Monash-EPHM-Lab/velocity/README.md

# velocity
Repository for Monash BoSL In water velocity sensor
