Monash-EPHM-Lab/velocity/Charaterisations/Flow Velocity Graph.png

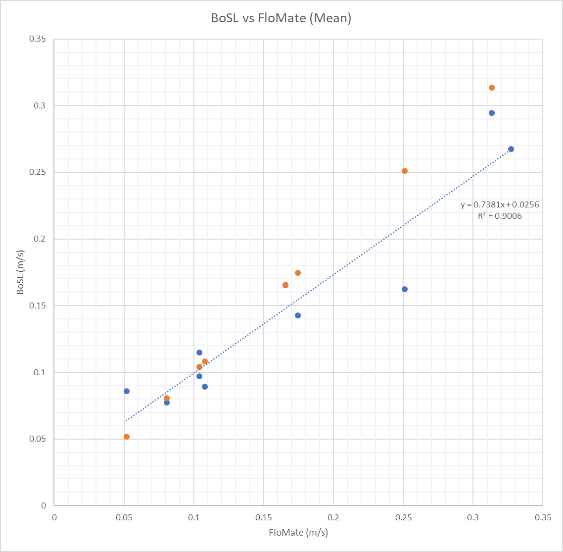
Charaterisations/Flow Velocity Graph.png
