Monash-EPHM-Lab/velocity/LT Simulations/Amp Simulation/Circuit.PNG

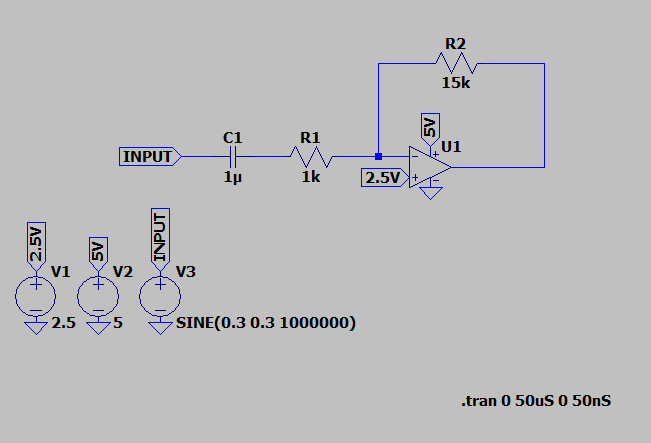
LT Simulations/Amp Simulation/Circuit.PNG
