Monash-EPHM-Lab/velocity/LT Simulations/Amp Simulation/Signals.PNG

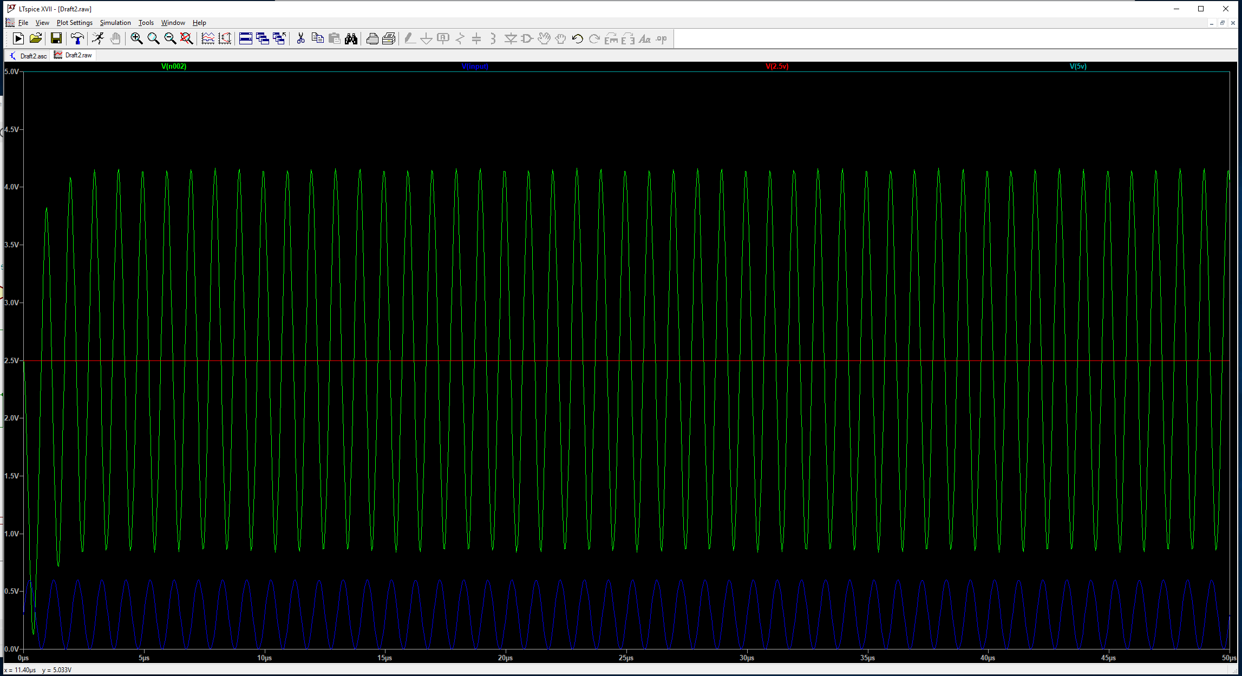
LT Simulations/Amp Simulation/Signals.PNG
