Monash-EPHM-Lab/velocity/EDA/Velocity BOM.xlsx

Part Number | Package Size / Type | Schematic Designator | Component | Value | QTY per board | Unit Price (USD) | Total Price (USD) | Supplier
 |  | LS1, LS2 | 1 MHz Ultrasonic Tranducer |  | 2 | $5.00 | $10.00
 | 0603 | C1 - C5 | SMD Capcitor | 100 nF | 5 | $0.10 | $0.50
 | 0402 | C6 - C10 | SMD Capcitor | 100 nF | 5 | $0.10 | $0.50
 | 0603 | C11 | SMD Capcitor | 22 nF | 1 | $0.10 | $0.10
 | 0603 | C12, C13 | SMD Capcitor | 18 pF | 2 | $0.10 | $0.20
 | 0603 | C14 | SMD Capcitor | 4.7 μF | 1 | $0.10 | $0.10
 | 0603 | C15, C16, C17 | SMD Capcitor | 330 pF | 3 | $0.10 | $0.30
 | 0805 | C18 | SMD Capcitor | 3.3 μF | 1 | $0.10 | $0.10
 | 0603 | C19 - C25 | SMD Capcitor | 1 μF | 8 | $0.10 | $0.80
 | 0805 | C26, C27, C28 | SMD Capcitor | 10 μF | 3 | $0.10 | $0.30
 | 0603 | R1, R3 | SMD Resistor | 20 kΩ | 2 | $0.10 | $0.20
 | 0603 | R2 | SMD Resistor | 3.3 kΩ | 1 | $0.10 | $0.10
 | 0603 | R7, R9 | SMD Resistor | 330 Ω | 2 | $0.10 | $0.20
 | 0603 | R12 | SMD Resistor | 200 Ω | 1 | $0.10 | $0.10
 | 0603 | R13 | SMD Resistor | 100 Ω | 1 | $0.10 | $0.10
 | 0603 | R4, R8, R10, R14, R15 | SMD Resistor | 10 kΩ | 5 | $0.10 | $0.50
 | 0603 | R17 | SMD Resistor | 15 kΩ | 1 | $0.10 | $0.10
 | 0603 | R5, R16 | SMD Resistor | 1 kΩ | 2 | $0.10 | $0.20
 | 0603 | R6 | SMD Resistor | 2.8 MΩ | 1 | $0.10 | $0.10
 | 0603 | R11 | SMD Resistor | 500 kΩ | 1 | $0.10 | $0.10
BLM18PG471SN1D | 0603 | L1 | SMD Inductor |  | 1 | $0.10 | $0.10 | https://au.mouser.com/ProductDetail/Murata-Electronics/BLM18PG471SN1D?qs=EYzdjubb4S%2FN1Ip39GrHyg%3D%3D
XFL4020-472MEC | 4x4mm | L2 | SMD Inductor | 4.7 μH | 1 | $3.00 | $3.00 | https://au.mouser.com/ProductDetail/Coilcraft/XFL4020-472MEC?qs=zCSbvcPd3pYTqnxfKsElWw%3D%3D
SA612AD | SOIC-8 | U1 | RF Mixer |  | 1 | $2.29 | $2.29 | https://www.digikey.com/product-detail/en/nxp-usa-inc/SA612AD-01112/568-1204-5-ND/740395
OPA4354 | SOIC-14 | U2 | 4xOPAmp |  | 1 | $1.80 | $1.80 | https://www.digikey.com/product-detail/en/texas-instruments/OPA4354AIDR/296-12643-2-ND/454201
MAX7375AXR105 | SOT-323/SC-70 | U3 | Oscilator |  | 1 | $1.56 | $1.56 | https://www.digikey.com/product-detail/en/maxim-integrated/MAX7375AXR105-T/MAX7375AXR105-TCT-ND/4490142
ATSAMD21G18A | QFP50-48 | U4 | Microcontroller |  | 1 | $3.00 | $3.00 | https://www.microchip.com/wwwproducts/en/ATsamd21g18
TPS61222 | SC70-6 | U5 | Boost Converter |  | 1 | $1.80 | $1.80 | https://au.mouser.com/ProductDetail/Texas-Instruments/TPS61222DCKR?qs=IDSsxkoac0xpx0kmXXJcTA%3D%3D
AD8226BRZ | SOIC-8 | U6 | Instrumentation Amplifier |  | 1 | $5.00 | $5.00 | https://www.digikey.com/product-detail/en/analog-devices-inc/AD8226BRZ/AD8226BRZ-ND/2182229
SP3075 | SOIC-8 | U7 | RS485 Bus |  | 1 | $2.54 | $2.54 | https://au.element14.com/exar/sp3075een-l/transceiver-rs-485-3v-smd-3075/dp/9386688
FX255 | 4.9mm x 1.8mm | Y1 | Crystal Oscilator | 32.768 kHz | 1 | $1.96 | $1.96 | https://au.rs-online.com/web/p/crystal-units/6480222/
 |  |  |  |  |  |  | $0.00
 |  |  |  |  |  |  | $0.00
 |  |  |  |  |  |  | $0.00
 |  |  |  |  |  |  | $0.00
 |  |  |  |  |  |  | $0.00
 |  |  |  |  |  |  | $0.00
 |  |  |  |  |  |  | $0.00
 |  |  |  |  |  |  | $0.00
 |  |  |  |  |  |  | $0.00
