Monash-EPHM-Lab/velocity/CAD/Small Tranducer/VelocityFRONT.stl

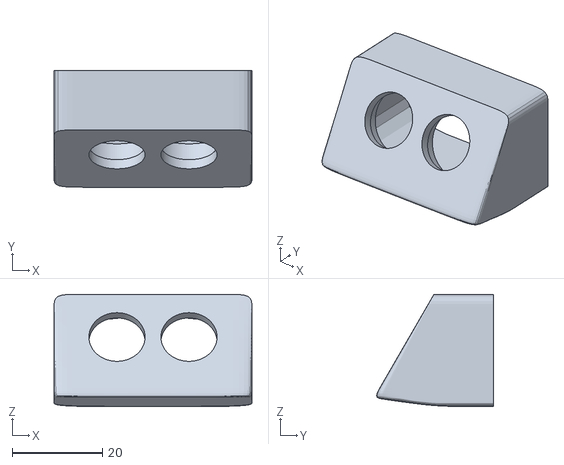
[picture p4: CAD file, 2020-08-11]
CAD/Small Tranducer/VelocityFRONT.stl
44.0 x 25.9 x 25.0
