Monash-EPHM-Lab/velocity/CAD/Velocity_Back.stl

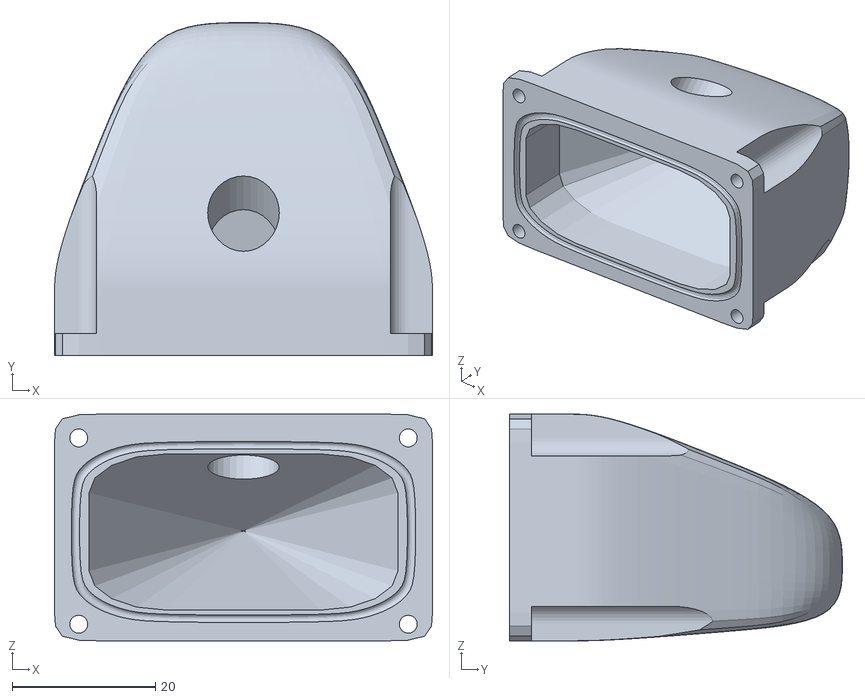
[picture p5: CAD file, 2020-08-11]
CAD/Velocity_Back.stl
52.8 x 46.4 x 31.7
