Monash-EPHM-Lab/velocity/CAD/Small Tranducer/VelocityQUICK.stl

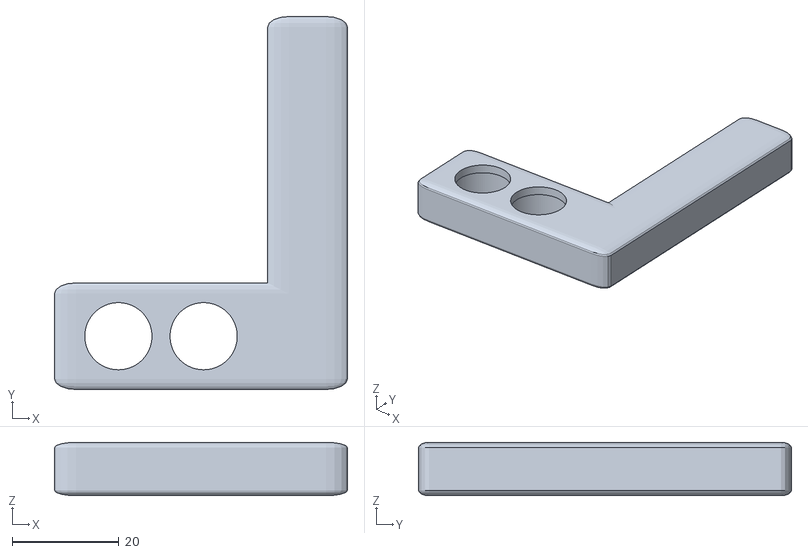
[picture p6: CAD file, 2020-08-11]
CAD/Small Tranducer/VelocityQUICK.stl
55.0 x 70.0 x 10.0
