Monash-EPHM-Lab/velocity/CAD/Velocity_Front.stl

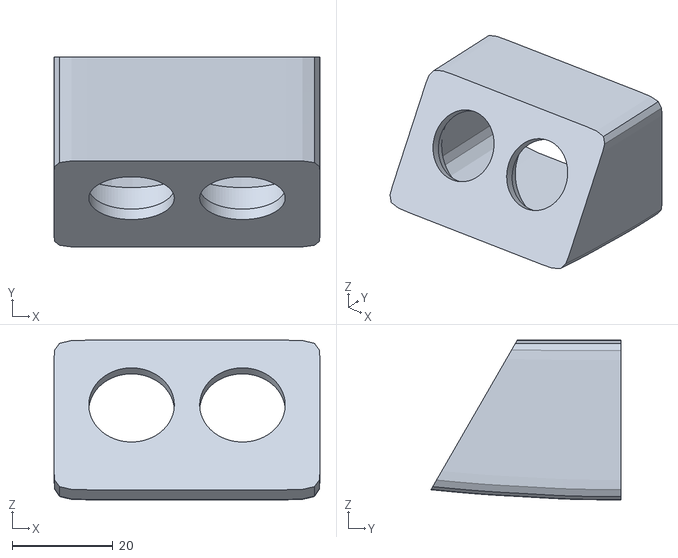
[picture p7: CAD file, 2020-08-11]
CAD/Velocity_Front.stl
52.8 x 37.7 x 31.7
