Monash-EPHM-Lab/velocity/CAD/Small Tranducer/VelocityBACK.stl

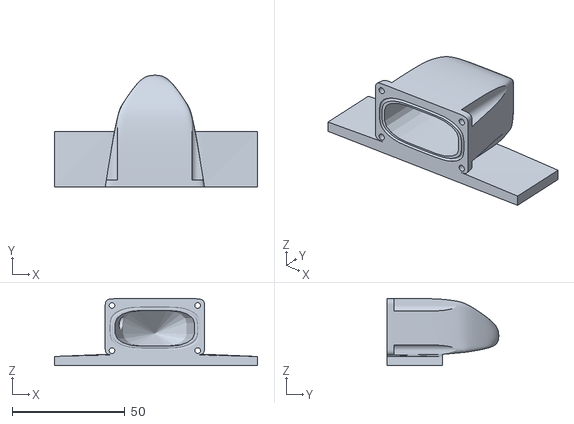
[picture p8: CAD file, 2020-08-11]
CAD/Small Tranducer/VelocityBACK.stl
90.0 x 49.5 x 29.7
