Monash-EPHM-Lab/velocity/(list of files, cad)

Other CAD files:
CAD/Small Tranducer/VelocitySmall.blend
CAD/Velocity.blend
