Monash-EPHM-Lab/velocity/LT Simulations/Heterodyne.asc

C1: cap; 100n
C2: cap; 100n
R1: res; 10k
R2: res; 10k
R3: res; 100
R4: res; 10k
U1: opamp
V1: voltage; SINE(0 AC 1 10000000); AC 1 1000000
V2: voltage; SINE(0 0.1 100)
.lib opamp.sub
.tran 0 30m 0 .1u
