Monash-EPHM-Lab/velocity/LT Simulations/Amp Simulation/TransducerAmp.asc

C1: cap; 1µ
R1: res; 1k
R2: res; 15k
U1: UniversalOpamp2
V1: voltage; 2.5
V2: voltage; 5
V3: voltage; SINE(0.3 0.3 1000000)
V4: voltage; -5
Named nets: 2.5V, 0, 5V, INPUT, -5V
.tran 0 50uS 0 50nS
