Monash-EPHM-Lab/velocity/EDA/Heterodyne/Heterodyne.kicad_pcb

## KiCad design EDA/Heterodyne/Heterodyne.kicad_pcb (2020-08-11)

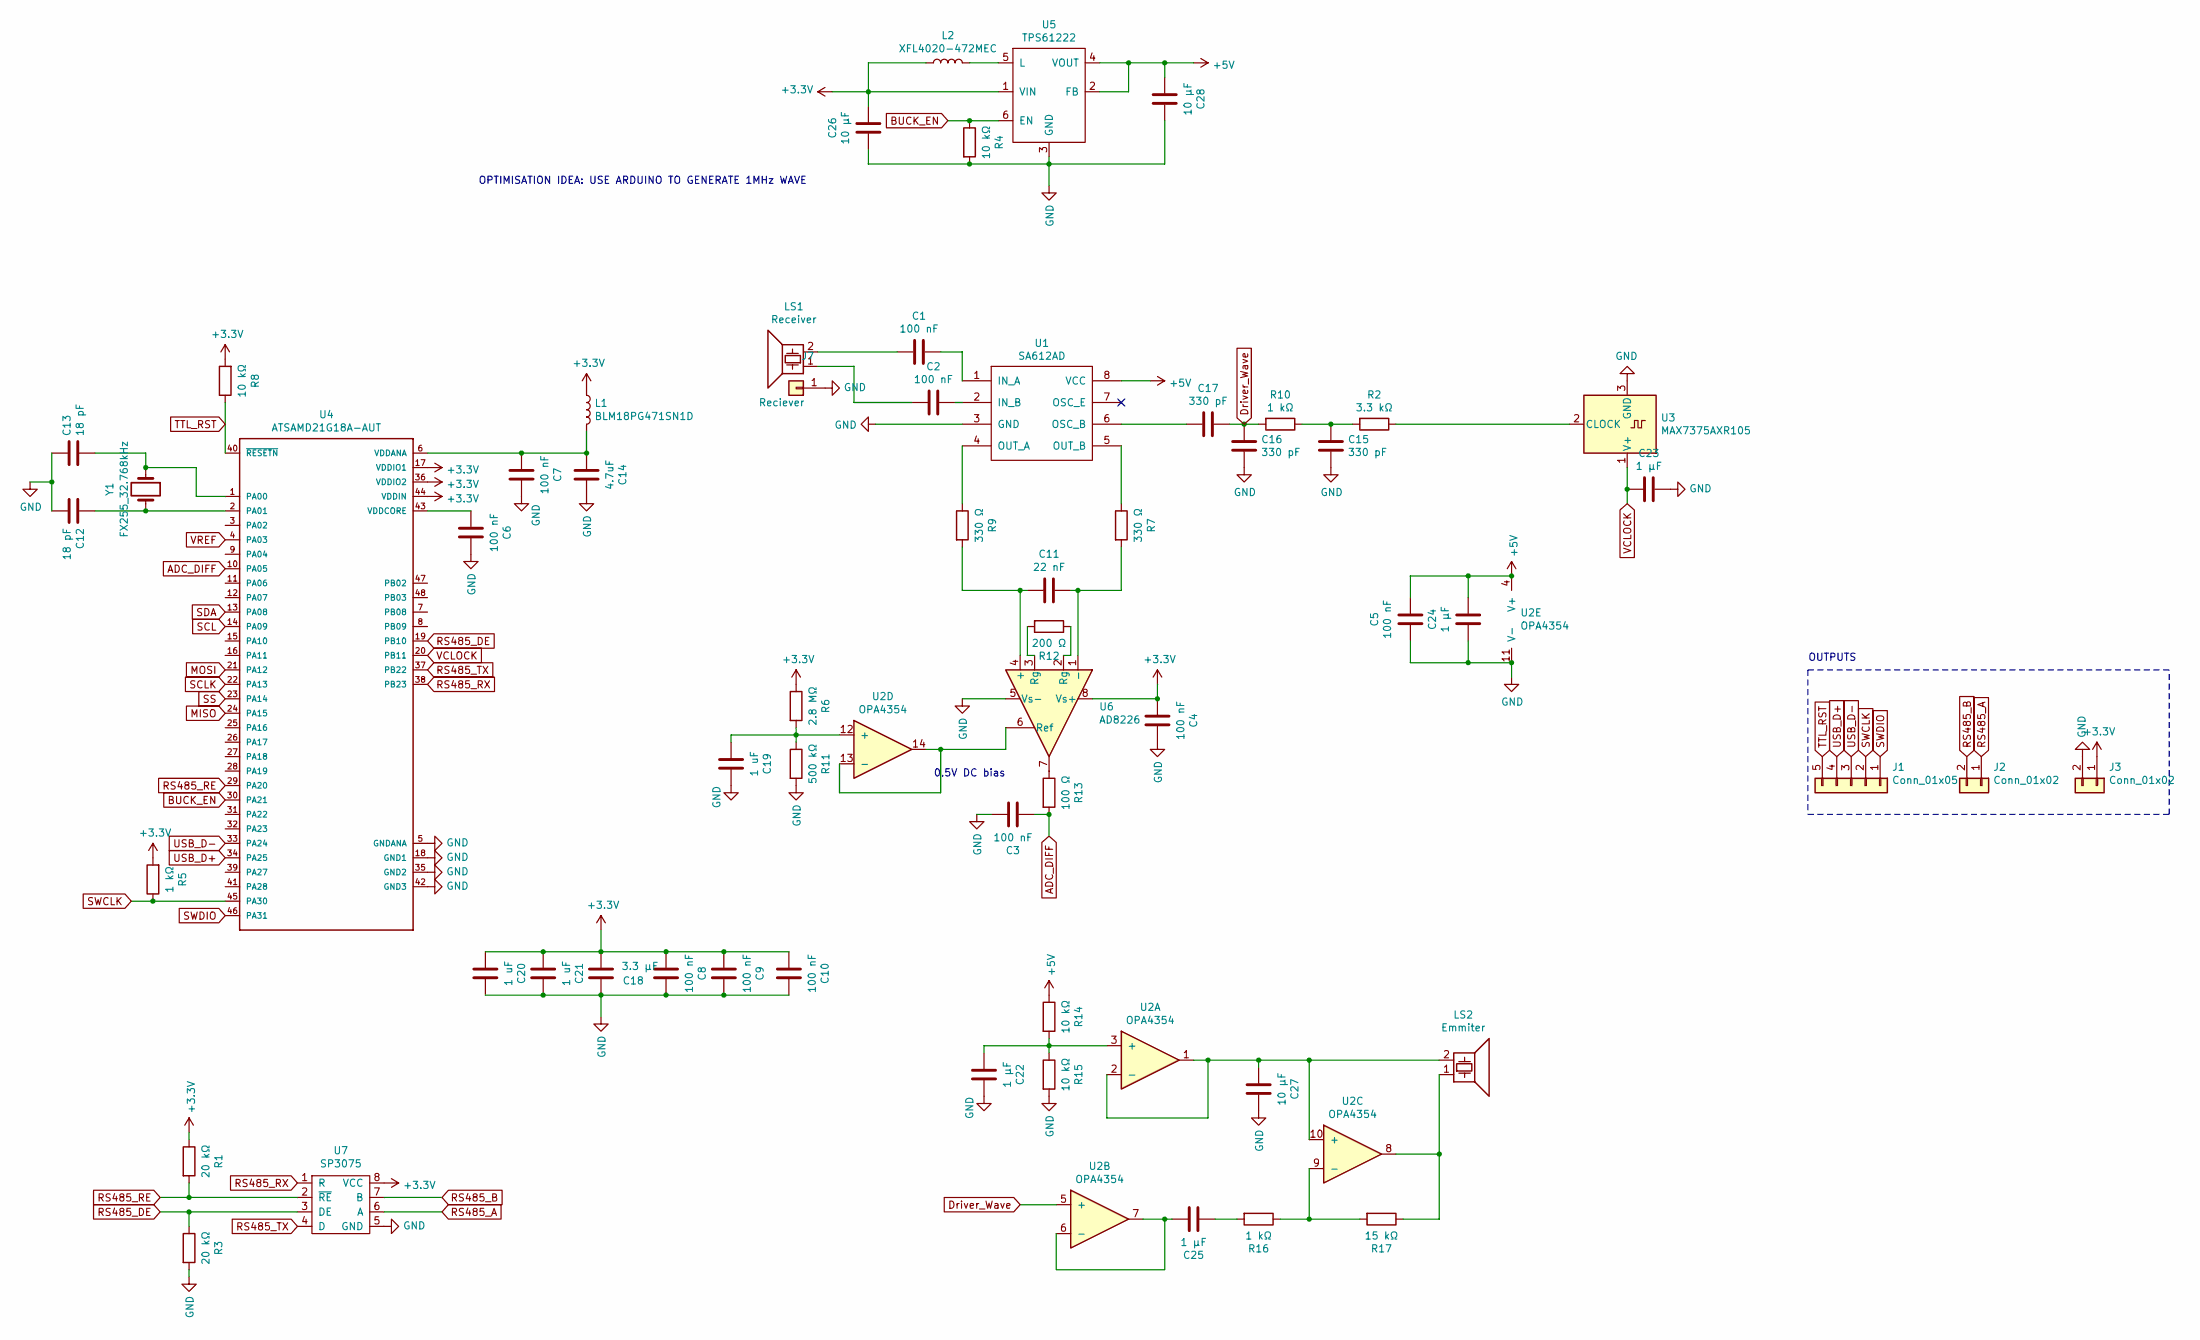
[picture p9: schematic Heterodyne.sch]

Parts:
C1, C2, C3, C4, C5: 100 nF; C_0603_1608Metric_Pad1.05x0.95mm_HandSolder
C6, C7, C8, C9, C10: 100 nF; C_0402_1005Metric
C11: 22 nF; C_0603_1608Metric_Pad1.05x0.95mm_HandSolder
C12, C13: 18 pF; C_0603_1608Metric_Pad1.05x0.95mm_HandSolder
C14: 4.7uF; C_0603_1608Metric
C15, C16, C17: 330 pF; C_0603_1608Metric_Pad1.05x0.95mm_HandSolder
C18: 3.3 μF; C_0805_2012Metric
C19, C20, C21: 1 uF; C_0603_1608Metric_Pad1.05x0.95mm_HandSolder
C22: 1 μF; C_0603_1608Metric_Pad1.05x0.95mm_HandSolder
C23, C24, C25: 1 μF; C_0603_1608Metric
C26, C27, C28: 10 μF; C_0805_2012Metric
J1: Conn_01x05; PinHeader_1x05_P2.54mm_Vertical
J2, J3: Conn_01x02; PinHeader_1x02_P2.54mm_Vertical
J7: Reciever; PinSocket_1x01_P2.54mm_Vertical
L1: BLM18PG471SN1D; C_0603_1608Metric
L2: XFL4020-472MEC; L_Coilcraft_XxL4020
LS1: Receiver; PinHeader_1x02_P2.54mm_Vertical
LS2: Emmiter; PinHeader_1x02_P2.54mm_Vertical
R1, R3: 20 kΩ; R_0603_1608Metric_Pad1.05x0.95mm_HandSolder
R2: 3.3 kΩ; R_0603_1608Metric_Pad1.05x0.95mm_HandSolder
R4, R8, R14, R15: 10 kΩ; R_0603_1608Metric_Pad1.05x0.95mm_HandSolder
R5: 1 kΩ; R_0603_1608Metric
R6: 2.8 MΩ; R_0603_1608Metric_Pad1.05x0.95mm_HandSolder
R7, R9: 330 Ω; R_0603_1608Metric_Pad1.05x0.95mm_HandSolder
R10, R16: 1 kΩ; R_0603_1608Metric_Pad1.05x0.95mm_HandSolder
R11: 500 kΩ; R_0603_1608Metric_Pad1.05x0.95mm_HandSolder
R12: 200 Ω; R_0603_1608Metric_Pad1.05x0.95mm_HandSolder
R13: 100 Ω; R_0603_1608Metric_Pad1.05x0.95mm_HandSolder
R17: 15 kΩ; R_0603_1608Metric_Pad1.05x0.95mm_HandSolder
U1: SA612AD; SOIC-8_5.275x5.275mm_P1.27mm
U2: OPA4354
U3: MAX7375AXR105; SOT-323_SC-70_Handsoldering
U4: ATSAMD21G18A-AUT; QFP50P900X900X120-48N
U5: TPS61222; SOT-363_SC-70-6
U6: AD8226; SOIC-8_3.9x4.9mm_P1.27mm
U7: SP3075; SOIC-8_3.9x4.9mm_P1.27mm
Y1: FX255_32.768kHz; Crystal_SMD_MicroCrystal_CC4V-T1A-2Pin_5.0x1.9mm

Connections:
+3V3: C4.2, C8.2, C9.2, C10.2, C18.2, C20.2, C21.2, C26.1, J3.1, L1.1, L2.1, R1.1, R5.2, R6.1, R8.2, U4.17 (VDDIO1), U4.36 (VDDIO2), U4.44 (VDDIN), U5.1 (VIN), U6.8 (Vs+), U7.8 (VCC)
+5V: C5.1, C24.1, C28.2, R14.1, U1.8 (VCC), U2.4 (V+), U5.2 (FB), U5.4 (VOUT); also elsewhere on the board
ADC_DIFF: C3.2, R13.2, U4.10 (PA05)
BUCK_EN: R4.1, U4.30 (PA21), U5.6 (EN)
Driver_Wave: C16.2, C17.1, R10.2, U2.5 (+)
GND: C3.1, C4.1, C5.2, C6.1, C7.1, C8.1, C9.1, C10.1, C12.2, C13.1, C14.1, C15.2, C16.1, C18.1, C19.1, C20.1, C21.1, C22.1, C23.1, C24.2, C26.2, C27.1, C28.1, J3.2, J7.1, R3.2, R4.2, R11.2, R15.2, U1.3 (GND), U2.11 (V-), U3.3 (GND), U4.5 (GNDANA), U4.18 (GND1), U4.35 (GND2), U4.42 (GND3), U5.3 (GND), U6.5 (Vs-), U7.5 (GND); also elsewhere on the board
MISO: U4.24 (PA15)
MOSI: U4.21 (PA12)
unnamed: C1.1, U1.1 (IN_A)
unnamed: C1.2, LS1.2
unnamed: C2.1, U1.2 (IN_B)
unnamed: C2.2, LS1.1
unnamed: C6.2, U4.43 (VDDCORE)
unnamed: C11.1, R7.2, U6.1 (-)
unnamed: C11.2, R9.2, U6.4 (+)
unnamed: C12.1, U4.2 (PA01), Y1.2
unnamed: C13.2, U4.1 (PA00), Y1.1
unnamed: C7.2, C14.2, L1.2, U4.6 (VDDANA)
unnamed: C15.1, R2.2, R10.1
unnamed: C17.2, U1.6 (OSC_B)
unnamed: C19.2, R6.2, R11.1, U2.12 (+)
unnamed: C22.2, R14.2, R15.1, U2.3 (+)
unnamed: C25.1, U2.6 (-), U2.7
unnamed: C25.2, R16.2
unnamed: C27.2, LS2.2, U2.1, U2.2 (-), U2.10 (+)
unnamed: L2.2, U5.5 (L)
unnamed: LS2.1, R17.1, U2.8
unnamed: R2.1, U3.2 (CLOCK)
unnamed: R7.1, U1.5 (OUT_B)
unnamed: R9.1, U1.4 (OUT_A)
unnamed: R12.1, U6.2 (Rg)
unnamed: R12.2, U6.3 (Rg)
unnamed: R13.1, U6.7
unnamed: R16.1, R17.2, U2.9 (-)
unnamed: U2.13 (-), U2.14, U6.6 (Ref)
RS485_A: J2.1, U7.6 (A)
RS485_B: J2.2, U7.7 (B)
RS485_DE: R3.1, U4.19 (PB10), U7.3 (DE)
RS485_RE: R1.2, U4.29 (PA20), U7.2 (~RE)
RS485_RX: U4.38 (PB23), U7.1 (R)
RS485_TX: U4.37 (PB22), U7.4 (D)
SCL: U4.14 (PA09)
SCLK: U4.22 (PA13)
SDA: U4.13 (PA08)
SS: U4.23 (PA14)
SWCLK: J1.2, R5.1, U4.45 (PA30)
SWDIO: J1.1, U4.46 (PA31)
TTL_RST: J1.5, R8.1, U4.40 (~RESETN~)
USB_D+: J1.4, U4.34 (PA25)
USB_D-: J1.3, U4.33 (PA24)
VCLOCK: C23.2, U3.1 (V+), U4.20 (PB11)
VREF: U4.4 (PA03)

Notes on the sheet:
OUTPUTS
OPTIMISATION IDEA: USE ARDUINO TO GENERATE 1MHz WAVE
0.5V DC bias

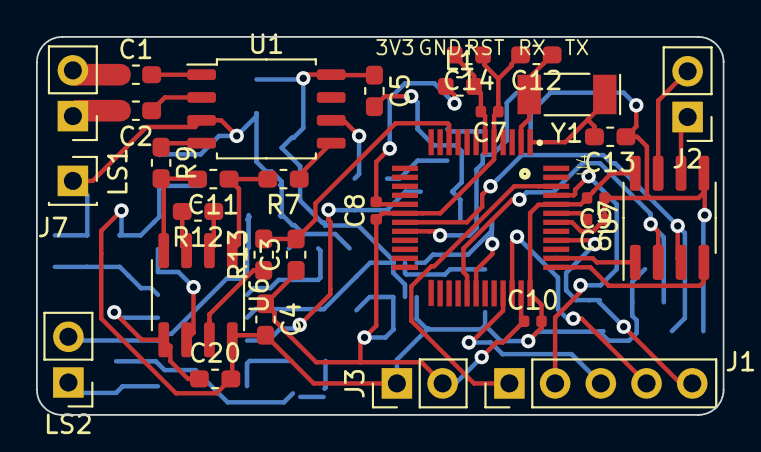
[picture p10: board Heterodyne.kicad_pcb from above]

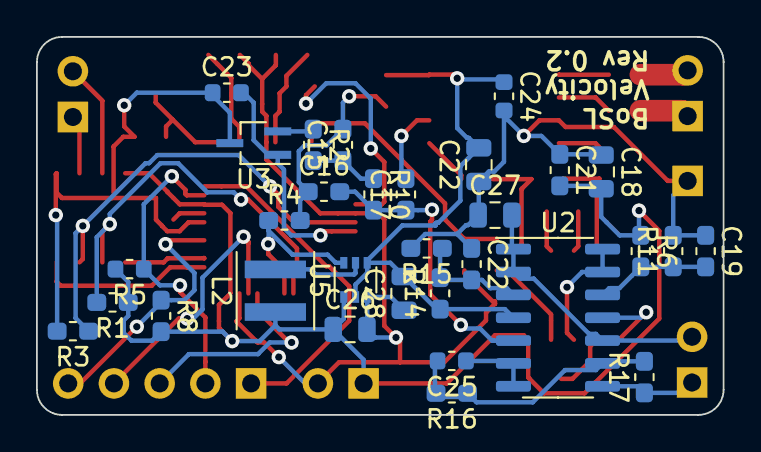
[picture p11: board Heterodyne.kicad_pcb from below]

Board: 4 copper layers, 38.2 x 21.0 mm, 62 parts (31 on the bottom side), 45 nets.

Other parts of the board:
C22#2: 2.2 μF; C_0805_2012Metric

Their connections:
+5V: C22#2.2; also elsewhere on the board
GND: C22#2.1; also elsewhere on the board
