Monash-EPHM-Lab/velocity/Charaterisations/ADC FFT 3V3 Calibration.xlsx

Frequency (Hz) | Sample Setting FFT bin
Input | *0 | *1 | *2 | *3 | *4
20 | 4 | 2 | 2 | 2 | 2
40 | 8 | 4 | 2 | 2 | 2
80 | 16 | 8 | 4 | 2 | 2
160 | 32 | 16 | 8 | 4 | 2
320 | 63 | 32 | 15 | 8 | 4
640 | 2 | 63 | 31 | 16 | 8
1280 | 3 | 2 | 61 | 32 | 16
2560 | 6 | 2 | 5 | 63 | 33
5120 | 13 | 2 | 10 | 2 | 63
