Monash-EPHM-Lab/velocity/Charaterisations/ADC FFT Calibration.xlsx

 | FFT BIN
Frequency (Hz) | 1600 μs | 800 μs | 400 μs | Fast
10 | 4 | 11.5 | 60.75 | 26.75
20 | 5 | 4 | 57 | 31.75
30 | 7 | 4 | 4 | 31.5
40 | 10 | 6 | 4 | 30.5
50 | 12 | 7 | 5 | 30.75
60 | 15 | 9 | 6 | 24.5
70 | 17 | 10 | 6 | 30.75
80 | 20 | 11 | 7 | 31.25
90 | 22 | 13 | 8 | 10.75
100 | 25 | 14 | 9 | 4
110 | 27 | 16 | 10 | 4
120 | 30 | 17 | 11 | 4
130 | 32 | 19 | 12 | 4
140 | 35 | 20 | 13 | 4
150 | 37 | 22 | 14 | 4
160 | 39 | 23 | 15 | 4
170 | 42 | 24 | 16 | 4
180 | 44 | 26 | 17 | 4
190 | 47 | 27 | 18 | 5
200 | 49 | 29 | 18 | 5
210 | 52 | 30 | 19 | 5
220 | 54 | 32 | 20 | 5
230 | 57 | 33 | 21 | 6
240 | 59 | 34 | 22 | 6
250 | 62 | 36 | 23 | 6
260 | 63 | 37 | 24 | 6
270 | 61 | 39 | 25 | 7
280 | 59 | 40 | 26 | 7
300 | 54 | 43 | 28 | 7
320 | 49 | 46 | 29 | 8
340 | 44 | 49 | 31 | 8
360 | 39 | 52 | 33 | 9
380 | 34 | 55 | 35 | 9
400 | 29 | 57 | 37 | 10
420 | 24 | 60 | 39 | 10
440 | 20 | 63 | 41 | 11
460 | 15 | 62 | 42 | 11
480 | 10 | 59 | 44 | 12
520 | 14 | 53 | 48 | 13
560 | 10 | 48 | 52 | 14
600 | 20 | 42 | 55 | 15
640 | 30 | 36 | 59 | 16
680 | 40 | 30 | 63 | 17
720 | 49 | 25 | 62 | 17
800 | 59 | 13 | 54 | 19
900 | 34 | 12.25 | 45 | 22
1000 | 10 | 16 | 36 | 24
1100 | 15 | 30 | 27 | 27
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
