Monash-EPHM-Lab/velocity/Charaterisations/Analog Characterisations.xlsx

Amplitude IN (mV) | Amplitude OUT (mV)
100 | 328
90 | 300
80 | 272
70 | 248
60 | 218
50 | 186
40 | 152
30 | 110
20 | 83
10 | 47
5 | 30
0 | 21
