Monash-EPHM-Lab/velocity/Charaterisations/Arduino Frequency Calibration.xlsx

 | Sample Frequency (ms)
Function Gen (Hz) | 2000 μs | 1000 μs | 500 μs | 250 μs | LIN
100 | 103.22 | 103.22 | 111.16 | 127.04 | 100
200 | 210.41 | 214.38 | 222.32 | 254.08 | 200
300 | 194.53 | 317.6 | 333.48 | 349.36 | 300
400 | 91.31 | 428.76 | 444.64 | 476.4 | 400
500 | 34.74 | 484.34 | 555.8 | 603.44 | 500
600 | 119.1 | 373.18 | 666.96 | 760.48 | 600
700 | 222.32 | 269.96 | 778.12 | 857.52 | 700
800 | 178.65 | 145.8 | 889.28 | 984.56 | 800
900 | 75.43 | 55.58 | 1000.44 | 1079.84 | 900
1000 | 27.79 | 55.58 | 921.04 | 1206.88 | 1000
1100 | 134.98 | 158.8 | 809.88 | 1333.92 | 1100
1200 | 238.2 | 269.96 | 698.72 | 1460.96 | 1200
1300 | 166.74 | 373.18 | 587.56 | 1588 | 1300
1400 | 59.55 | 484.34 | 476.4 | 1684.28 | 1400
1500 | 43.67 | 428.76 | 349.36 | 1810.32 | 1500
1600 | 146.89 | 325.54 | 238.2 | 1937.36 | 1600
1700 | 250.11 | 214.38 | 127.04 | 2000.88 | 1700
1800 | 150.86 | 111.16 | 178.65 | 1873.84 | 1800
1900 | 47.64 | 230.26 | 95.28 | 1748.8 | 1900
2000 | 59.55 | 103.22 | 206.44 | 1651.52 | 2000
2100 | 162.77 | 214.38 | 317.6 | 1524.48 | 2100
AFTER RECALIBRATION
Function Gen (Hz) | 2000 μs | 1000 μs | 500 μs | 250 μs | LIN
10 | 14.8 | 51.95 | 199.52 | 238.2 | 10
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
