Monash-EPHM-Lab/velocity/Charaterisations/In Water Calibration.xlsx

 | Block 1 |  |  | Block 2 |  | Block 3 |  | Block 4 |  | Block 5 |  | Block 6 |  | Block 7 |  | Block 8 |  | Block 9 |  | Block 10 |  | Block 11 |  | Block 12 |  | Block 13
 | FloMate | BoSL |  | FloMate | BoSL | FloMate | BoSL | FloMate | BoSL | FloMate | BoSL | FloMate | BoSL | FloMate | BoSL | FloMate | BoSL | FloMate | BoSL | FloMate | BoSL | FloMate | BoSL | FloMate | BoSL | FloMate | BoSL
 | 0.33 | 0.32 |  | 0.06 | 0.07 | 0.04 | 0.07 | 0.1 | 0.08 | 0.2 | 0.17 | 0.26 | 0.16 | 0.43 | 0.29 | 0.12 | 0.12 | 0.13 | 0.13 | 0.11 | 0.08 | 0.29 | 0.26 | 0.3 | 0.28 | 0.31 | 0.26
 | 0.31 | 0.2 |  | 0.06 | 0.08 | 0.04 | 0.07 | 0.1 | 0.08 | 0.21 | 0.17 | 0.28 | 0.29 | 0.4 | 0.27 | 0.13 | 0.15 | 0.11 | 0.1 | 0.1 | 0.08 | 0.31 | 0.22 | 0.44 | 0.25 | 0.31 | 0.23
 | 0.3 | 0.31 |  | 0.15 | 0.07 | 0.11 | 0.08 | 0.08 | 0.07 | 0.17 | 0.14 | 0.3 | 0.3 | 0.34 | 0.23 | 0.15 | 0.16 | 0.12 | 0.09 | 0.1 | 0.09 | 0.3 | 0.17 | 0.49 | 0.27 | 0.4 | 0.27
 | 0.33 | 0.28 |  | 0.19 | 0.15 | 0.01 | 0.11 | 0.08 | 0.09 | 0.13 | 0.17 | 0.38 | 0.28 | 0.36 | 0.31 | 0.2 | 0.13 | 0.11 | 0.09 | 0.11 | 0.09 | 0.3 | 0.16 | 0.44 | 0.19 | 0.4 | 0.21
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
