Monash-EPHM-Lab/velocity/Charaterisations/In Water Multi Calibration.xlsx

Sheet: Downstream
 | Downstream
 | 1 | BoSL |  |  |  | 2 | BoSL |  |  |  | 3 | BoSL |  |  |  | 4 | BoSL
 | FloMate | 2000 μs | 1000 μs | 500 μs | 250 μs | FloMate | 2000 μs | 1000 μs | 500 μs | 250 μs | FloMate | 2000 μs | 1000 μs | 500 μs | 250 μs | FloMate | 2000 μs | 1000 μs | 500 μs | 250 μs
 | mm/s | hz | hz | hz | hz | mm/s | hz | hz | hz | hz | mm/s | hz | hz | hz | hz | mm/s | hz | hz | hz | hz
 | 260 | 30.52 | 56.96 | 128.52 | 179.21 | 90 | 28.68 | 40.43 | 57.12 | 152.66 | 60 | 34.32 | 40.43 | 78.54 | 139.39 | 160 | 27.75 | 53.29 | 85.68 | 139.39
 | 240 | 19.42 | 51.45 | 67.83 | 252.22 | 90 | 36.08 | 53.29 | 82.11 | 152.66 | 60 | 19.42 | 55.12 | 57.12 | 298.66 | 150 | 40.7 | 93.71 | 107.1 | 146.02
 | 280 | 37 | 44.1 | 85.68 | 237.95 | 100 | 61.97 | 44.1 | 71.4 | 119.47 | 100 | 24.97 | 47.77 | 103.53 | 106.2 | 130 | 43.47 | 56.96 | 99.96 | 146.02
 | 260 | 24.05 | 34.91 | 92.82 | 139.39 | 100 | 37 | 31.24 | 89.25 | 116.2 | 90 | 28.67 | 51.45 | 71.46 | 152.66 | 130 | 29.6 | 36.75 | 110.67 | 159.3
 | 260 |  |  |  |  | 100 | 32.38 | 82.69 | 67.83 | 119.48 | 90 | 19.42 | 60.64 | 78.54 | 106.2 | 130
 | 260 |  |  |  |  | 100 |  |  |  |  | 80 |  |  |  |  | 140
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
