Monash-EPHM-Lab/velocity/(commit log)

2020-08-11 initial commit for split of monash-bosl repo into component projects
    [ADC FFT 3V3 Calibration.xlsx, ADC FFT Calibration.xlsx, ADC In Water 3.3V Calibration.xlsx, ADC Noise Calibration.xlsx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]
2020-08-11 reorganised files
    [ADC FFT 3V3 Calibration.xlsx, ADC FFT Calibration.xlsx, ADC In Water 3.3V Calibration.xlsx, ADC Noise Calibration.xlsx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]
2020-08-11 initial commit of SAMD21 branch
    [ADC FFT 3V3 Calibration.xlsx, ADC FFT Calibration.xlsx, ADC In Water 3.3V Calibration.xlsx, ADC Noise Calibration.xlsx, Analog Characterisations.xlsx, Arduino Frequency Calibration.xlsx, Back.stl, Front.stl]
